weeeha/story-dice/scad/shapes.scad

// GENERATED by tools/face_tables.py. Edit that script, not this file.
//
// Shape record: [name, V, F, K, glyph, tsize, iy, ty, lw, og, oy]
//   V      unit-scale vertices; the body is hull() of spheres at V*K
//   F      one frame per labelled face: [nx, ny, nz, ux, uy, uz, d]
//          n = outward normal, u = artwork up, d = plane distance at unit scale
//   K      scale to millimetres
//   glyph  icon size (mm); tsize label cap size (mm)
//   iy, ty icon and label offsets along u (mm)
//   lw     label room (mm): wider labels are condensed to fit
//   og, oy icon size and offset along u for the icon-only set (mm)

SHAPES = [
  ["d6",
    [[-1, -1, -1], [-1, -1, 1], [-1, 1, -1], [-1, 1, 1], [1, -1, -1], [1, -1, 1], [1, 1, -1], [1, 1, 1]],
    [[-1.0, 0.0, 0.0, 0.0, 0.0, -1.0, 1.0], [-0.0, -1.0, -0.0, -1.0, 0.0, 0.0, 1.0], [0.0, 0.0, -1.0, 0.0, -1.0, 0.0, 1.0], [-0.0, -0.0, 1.0, -1.0, 0.0, 0.0, 1.0], [0.0, 1.0, 0.0, 0.0, 0.0, -1.0, 1.0], [1.0, -0.0, -0.0, 0.0, -1.0, 0.0, 1.0]],
    8.000000, 8.00, 3.36, 2.280, -4.600, 14.80, 11.60, 0.000],
  ["d8",
    [[1, 0, 0], [-1, 0, 0], [0, 1, 0], [0, -1, 0], [0, 0, 1], [0, 0, -1]],
    [[0.57735, 0.57735, 0.57735, -0.408248, -0.408248, 0.816497, 0.57735], [0.57735, 0.57735, -0.57735, -0.408248, 0.816497, 0.408248, 0.57735], [0.57735, -0.57735, 0.57735, -0.408248, -0.816497, -0.408248, 0.57735], [0.57735, -0.57735, -0.57735, -0.408248, 0.408248, -0.816497, 0.57735], [-0.57735, 0.57735, 0.57735, 0.408248, 0.816497, -0.408248, 0.57735], [-0.57735, 0.57735, -0.57735, 0.408248, -0.408248, -0.816497, 0.57735], [-0.57735, -0.57735, 0.57735, 0.408248, 0.408248, 0.816497, 0.57735], [-0.57735, -0.57735, -0.57735, 0.408248, -0.816497, 0.408248, 0.57735]],
    19.595932, 8.00, 3.36, 2.280, -4.600, 20.50, 11.60, 0.000],
  ["d10",
    [[0, 0, 1], [0, 0, -1], [1.0, 0.0, 0.1055728090000841], [0.30901699437494745, 0.9510565162951535, 0.1055728090000841], [-0.8090169943749473, 0.5877852522924732, 0.1055728090000841], [-0.8090169943749475, -0.587785252292473, 0.1055728090000841], [0.30901699437494723, -0.9510565162951536, 0.1055728090000841], [0.8090169943749475, 0.5877852522924731, -0.1055728090000841], [-0.30901699437494734, 0.9510565162951536, -0.1055728090000841], [-1.0, 1.2246467991473532e-16, -0.1055728090000841], [-0.30901699437494756, -0.9510565162951535, -0.1055728090000841], [0.8090169943749473, -0.5877852522924734, -0.1055728090000841]],
    [[0.600006, 0.435904, 0.670806, -0.542694, -0.39429, 0.741633, 0.670824], [0.600006, -0.435904, 0.670806, -0.542694, 0.39429, 0.741633, 0.670824], [-0.229205, 0.705316, 0.670816, 0.207293, -0.637984, 0.741624, 0.670826], [-0.741621, 0.0, 0.670819, 0.670819, -0.0, 0.741621, 0.670819], [-0.229205, -0.705316, 0.670816, 0.207293, 0.637984, 0.741624, 0.670826], [0.741621, -0.0, -0.670819, -0.670819, 0.0, -0.741621, 0.670819], [0.229205, 0.705316, -0.670816, -0.207293, -0.637984, -0.741624, 0.670826], [-0.600006, 0.435904, -0.670806, 0.542694, -0.39429, -0.741633, 0.670824], [-0.600006, -0.435904, -0.670806, 0.542694, 0.39429, -0.741633, 0.670824], [0.229205, -0.705316, -0.670816, -0.207293, 0.637984, -0.741624, 0.670826]],
    18.715070, 8.00, 3.36, -0.520, -7.400, 17.78, 11.60, -4.800],
  ["d12",
    [[-1, -1, -1], [-1, -1, 1], [-1, 1, -1], [-1, 1, 1], [1, -1, -1], [1, -1, 1], [1, 1, -1], [1, 1, 1], [0, -0.6180339887498948, -1.618033988749895], [0, -0.6180339887498948, 1.618033988749895], [0, 0.6180339887498948, -1.618033988749895], [0, 0.6180339887498948, 1.618033988749895], [-0.6180339887498948, -1.618033988749895, 0], [-0.6180339887498948, 1.618033988749895, 0], [0.6180339887498948, -1.618033988749895, 0], [0.6180339887498948, 1.618033988749895, 0], [-1.618033988749895, 0, -0.6180339887498948], [-1.618033988749895, 0, 0.6180339887498948], [1.618033988749895, 0, -0.6180339887498948], [1.618033988749895, 0, 0.6180339887498948]],
    [[-0.850678, -0.525687, 0.0, -0.425289, 0.688213, 0.587785, 1.376426], [-0.525687, 0.0, -0.850678, 0.688213, 0.587785, -0.425289, 1.376426], [0.0, -0.850678, -0.525687, 0.587785, -0.425289, 0.688213, 1.376426], [-0.525687, -0.0, 0.850678, -0.262874, 0.951057, -0.162446, 1.376426], [0.0, -0.850678, 0.525687, 0.951057, 0.162446, 0.262874, 1.376426], [-0.850678, 0.525687, 0.0, 0.162446, 0.262874, 0.951057, 1.376426], [0.0, 0.850678, -0.525687, 0.951057, -0.162446, -0.262874, 1.376426], [-0.0, 0.850678, 0.525687, 0.587785, 0.425289, -0.688213, 1.376426], [0.850678, -0.525687, 0.0, -0.162446, -0.262874, 0.951057, 1.376426], [0.525687, -0.0, -0.850678, 0.262874, 0.951057, 0.162446, 1.376426], [0.525687, -0.0, 0.850678, -0.688213, 0.587785, 0.425289, 1.376426], [0.850678, 0.525687, -0.0, 0.425289, -0.688213, 0.587785, 1.376426]],
    9.404562, 8.00, 3.36, 2.280, -4.600, 11.50, 11.60, 0.000],
  ["tt",
    [[3, 1, 1], [1, 3, 1], [1, 1, 3], [3, -1, -1], [1, -3, -1], [1, -1, -3], [-3, 1, -1], [-1, 3, -1], [-1, 1, -3], [-3, -1, 1], [-1, -3, 1], [-1, -1, 3]],
    [[0.57735, 0.57735, -0.57735, 0.408248, 0.408248, 0.816497, 1.732051], [0.57735, -0.57735, 0.57735, 0.408248, -0.408248, -0.816497, 1.732051], [-0.57735, 0.57735, 0.57735, 0.816497, 0.408248, 0.408248, 1.732051], [-0.57735, -0.57735, -0.57735, 0.816497, -0.408248, -0.408248, 1.732051]],
    3.751045, 9.50, 3.36, 3.780, -3.850, 13.49, 13.78, 0.000]
];
