weeeha/story-dice/(commit log)

2026-10-16 Kit v2 story dice: sources, generator, renders, CI
    Moves the July 2026 Kit v2 dice out of weeeha/3D-Printing into a
    standalone repo that builds with OpenSCAD alone.
    - scad/story_die.scad: one library for every die (icon + label per face,
    body or ink inlay part). scad/kit.scad defines the ten dice.
    - tools/face_tables.py: the July hull-face generator, recovered from that
    session; regenerates scad/shapes.scad. d8 and d12 frames match kit-v2.
    - Conflict pair rebuilt as a rounded truncated tetrahedron instead of a
    third-party blank. Tree icon restored via a 0.01 mm icon offset.
    - Labels fit their faces: cube art square to the edges, d10 stack slid
    to the wide end of each kite, too-wide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
    [kit.scad, shapes.scad, story_die.scad]
2026-10-17 Keep icon proportions; move icon-only Want icons off the kite edges
    story_die.scad resized every icon outline to a glyph x glyph square, which
    stretched every icon that isn't square (eye 50%, hourglass 44%, dots-three
    133%). Scale Phosphor's 256-unit grid instead, so icons keep their shape and
    their size next to each other.
    The icon-only d10 cut its icons past the kite edges. face_tables.py now
    places the icon-only icon where the face has the most room (og, oy in
    shapes.scad): centred on every die except the d10, where it moves 4.8 mm
    towards the wide end.
    Adds tools/icon_audit.py, which checks every face of the built ink STLs for
    detail finer than the nozzle and artwork running off the fa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
    [shapes.scad, story_die.scad]
